R-Mutura/eco_boda_display/images/1 Eco_display.png

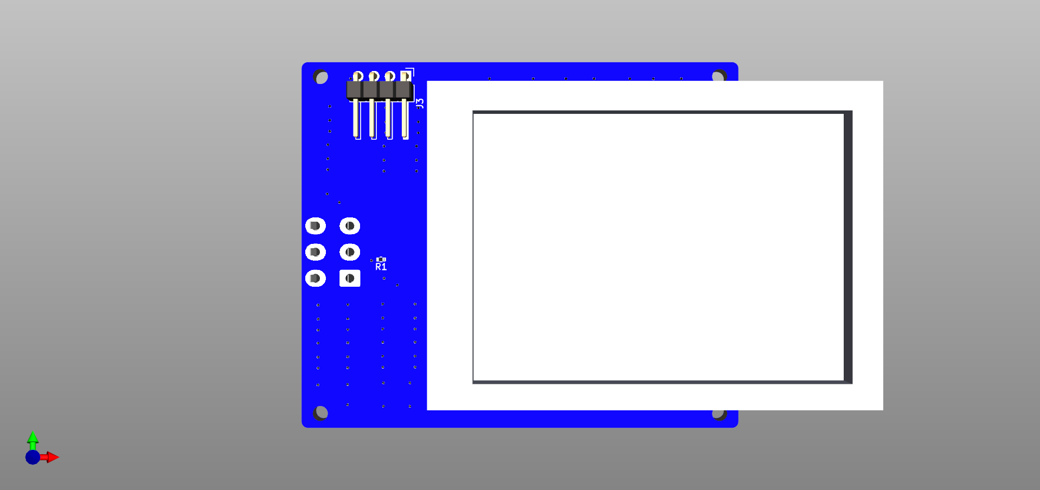
images/1 Eco_display.png
