R-Mutura/eco_boda_display/images/2 Eco_display.png

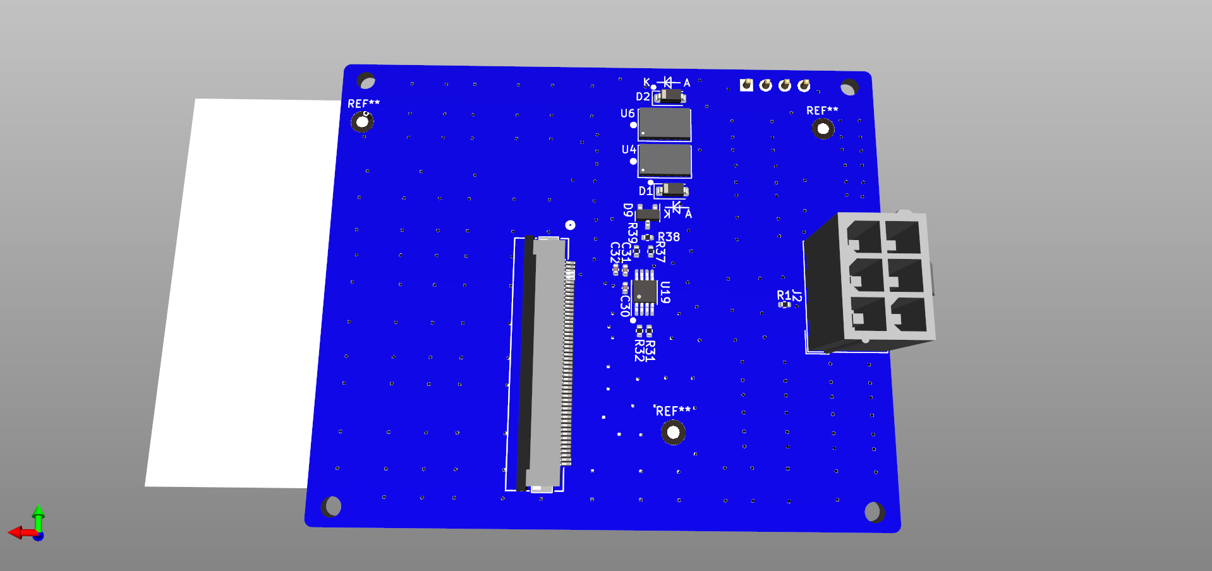
images/2 Eco_display.png
