R-Mutura/eco_boda_display/images/Eco_display.png

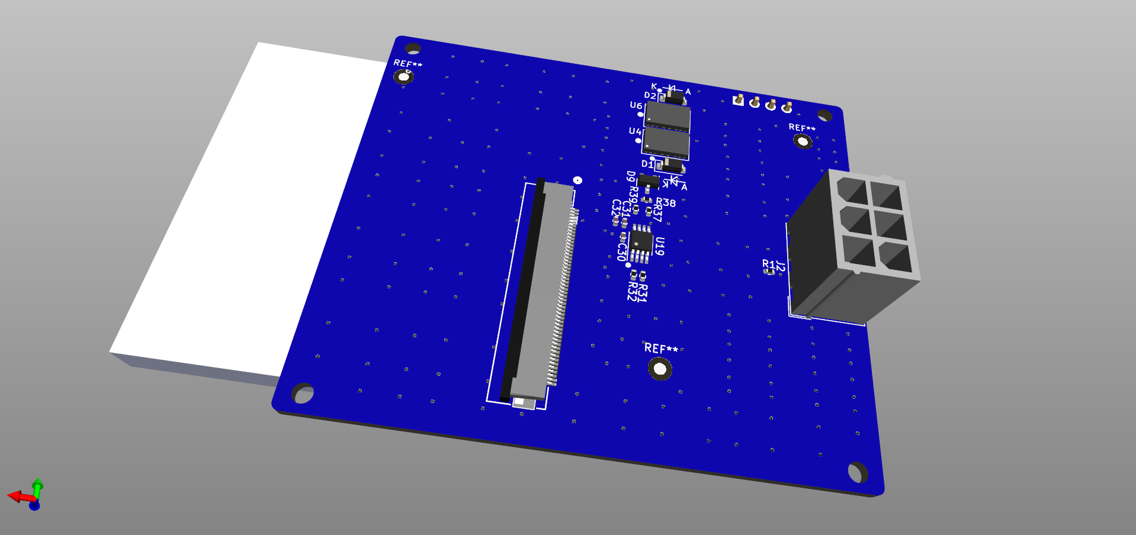
images/Eco_display.png
