R-Mutura/eco_boda_display/STEP/Eco_display.step

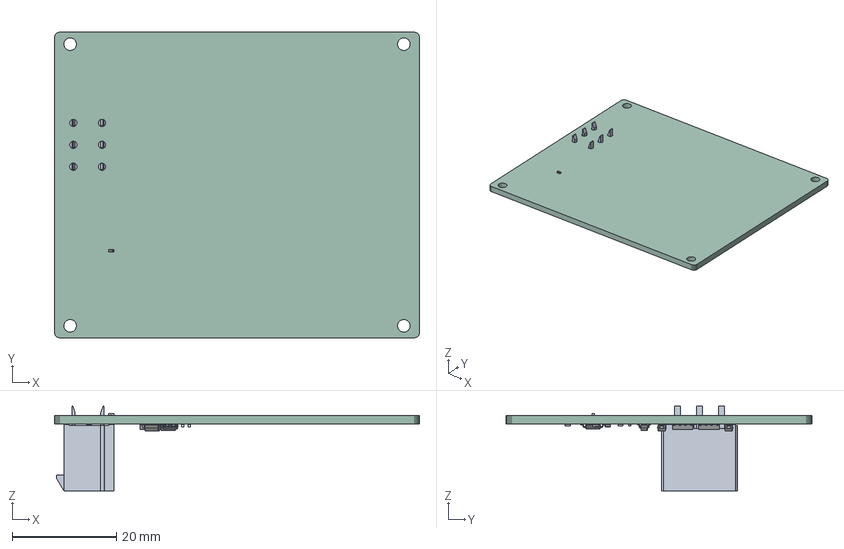
[picture p4: CAD file, 2024-01-16]
STEP/Eco_display.step
70.0 x 58.6 x 16.3 mm
R_0402_1005Metric x 6
TBU-CA065-300-WH x 2
SOT_23
C_0402_1005Metric x 3
MSOP_8_3x3mm_P065mm
D_SOD_123 x 2
Eco_display PCB
