R-Mutura/eco_boda_display/sch_pdf/Eco_display.pdf

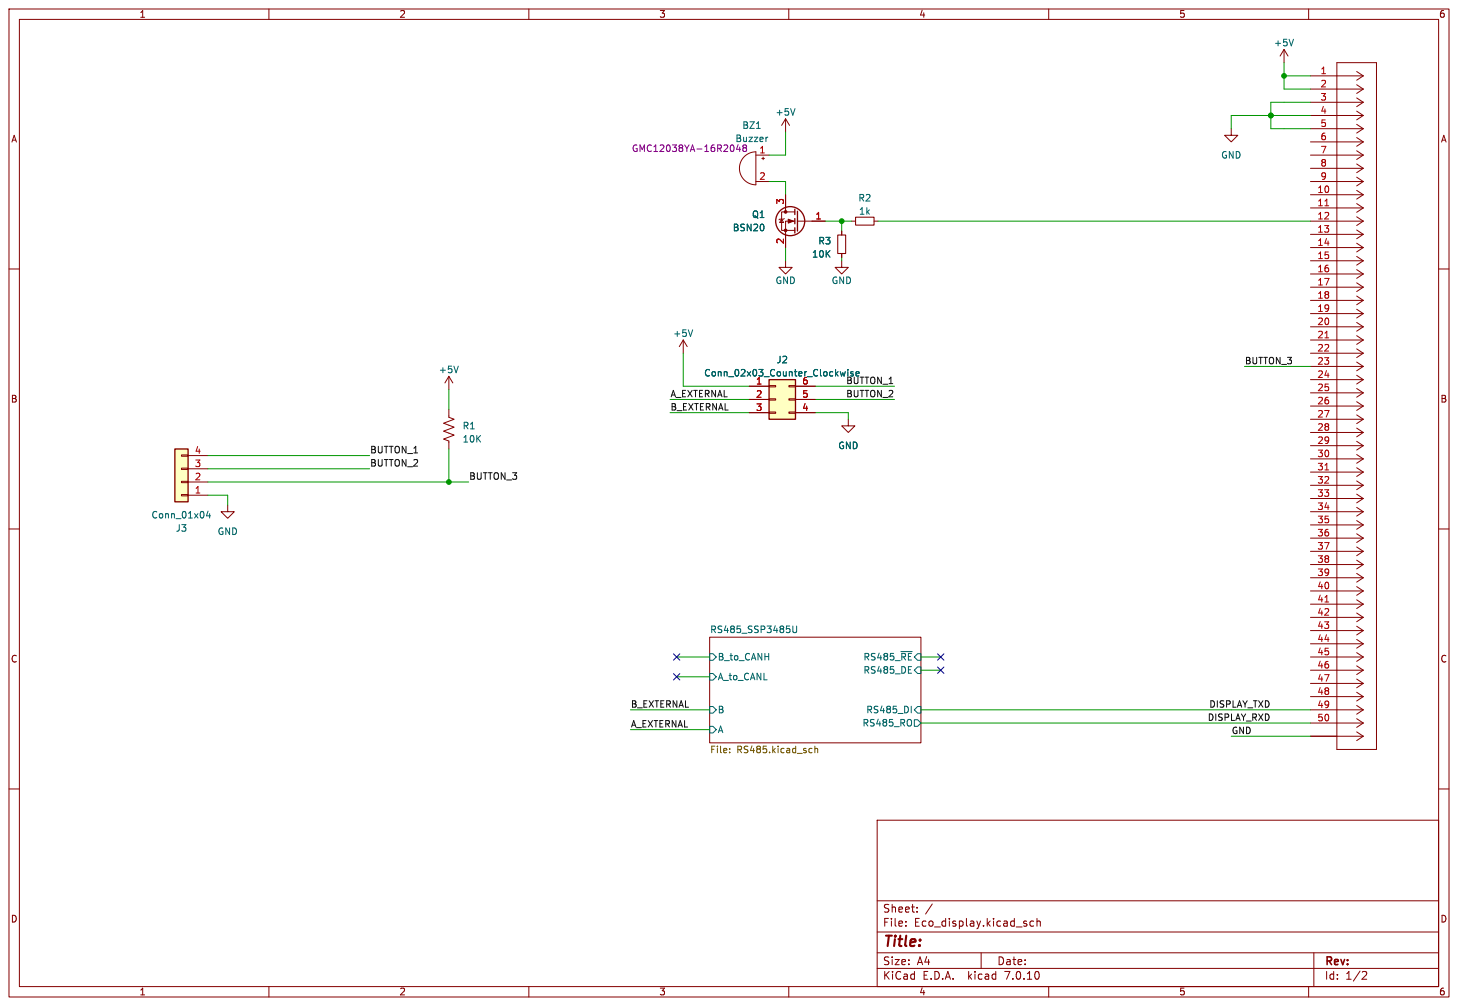
[picture p5: page 1]

Id: 1/2 Title: File: Eco_display.kicad_sch Sheet: / B_to_CANH

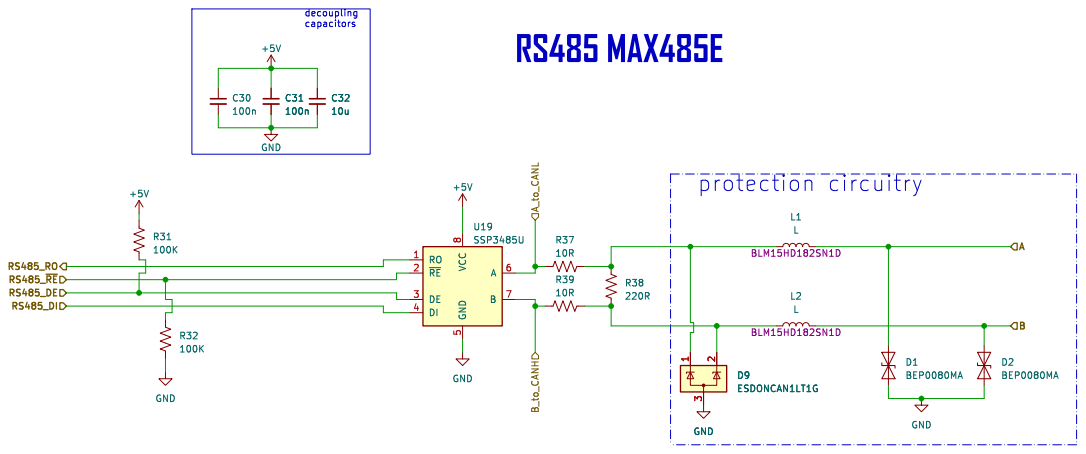
[picture p6: page 2]

decoupling capacitors

10u GND

Id: 2/2 Title: File: RS485.kicad_sch Sheet: /RS485_SSP3485U/ GND
