R-Mutura/eco_boda_display/sch_pdf/BOTTON_PLACEMENT_FILE_ECO_DISPLAY.pdf

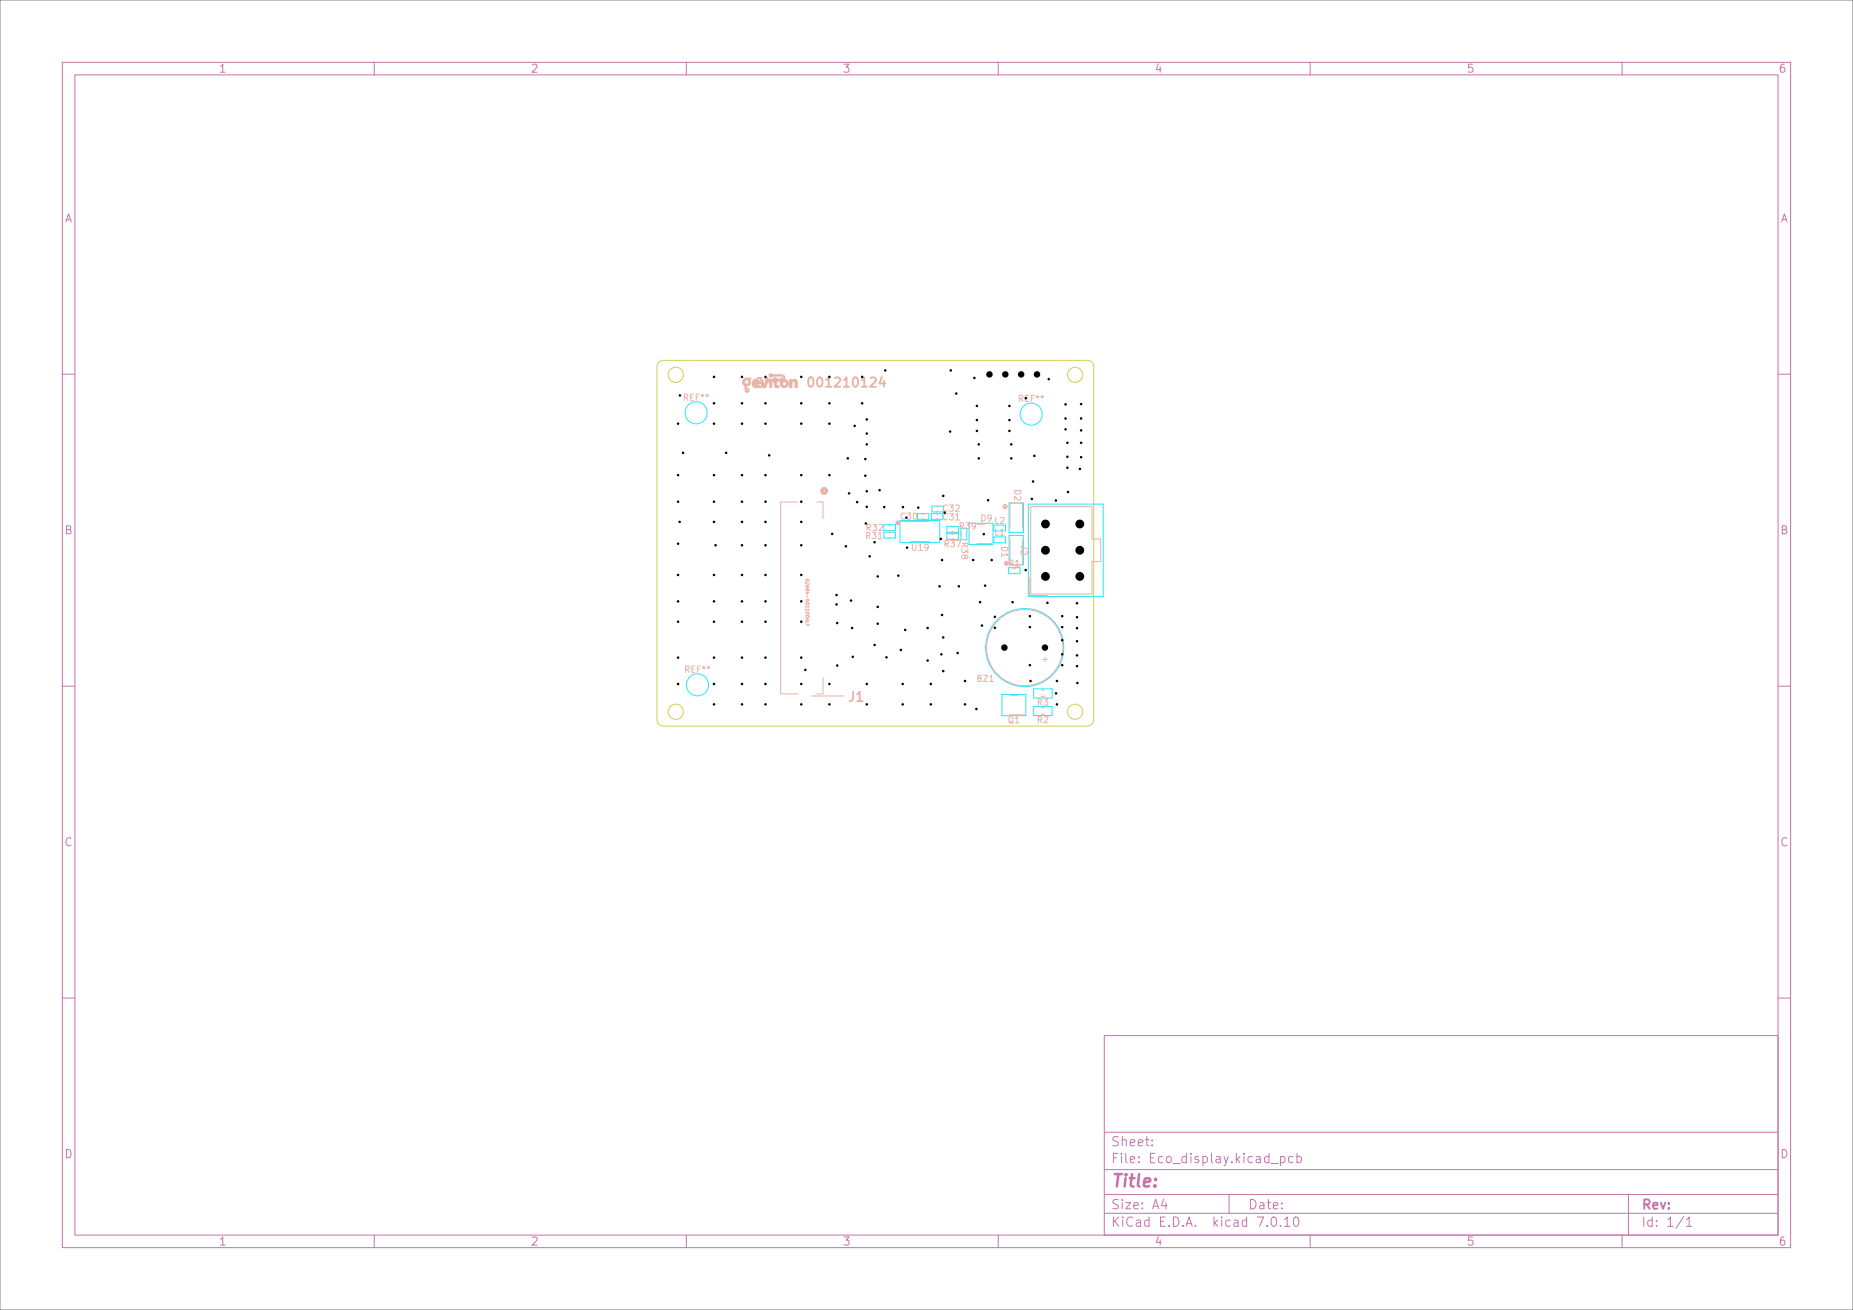
[picture p7: page 1]
