R-Mutura/eco_boda_display/sch_pdf/TOP_PLACEMENT_FILE_ECO_DISPLAY.pdf

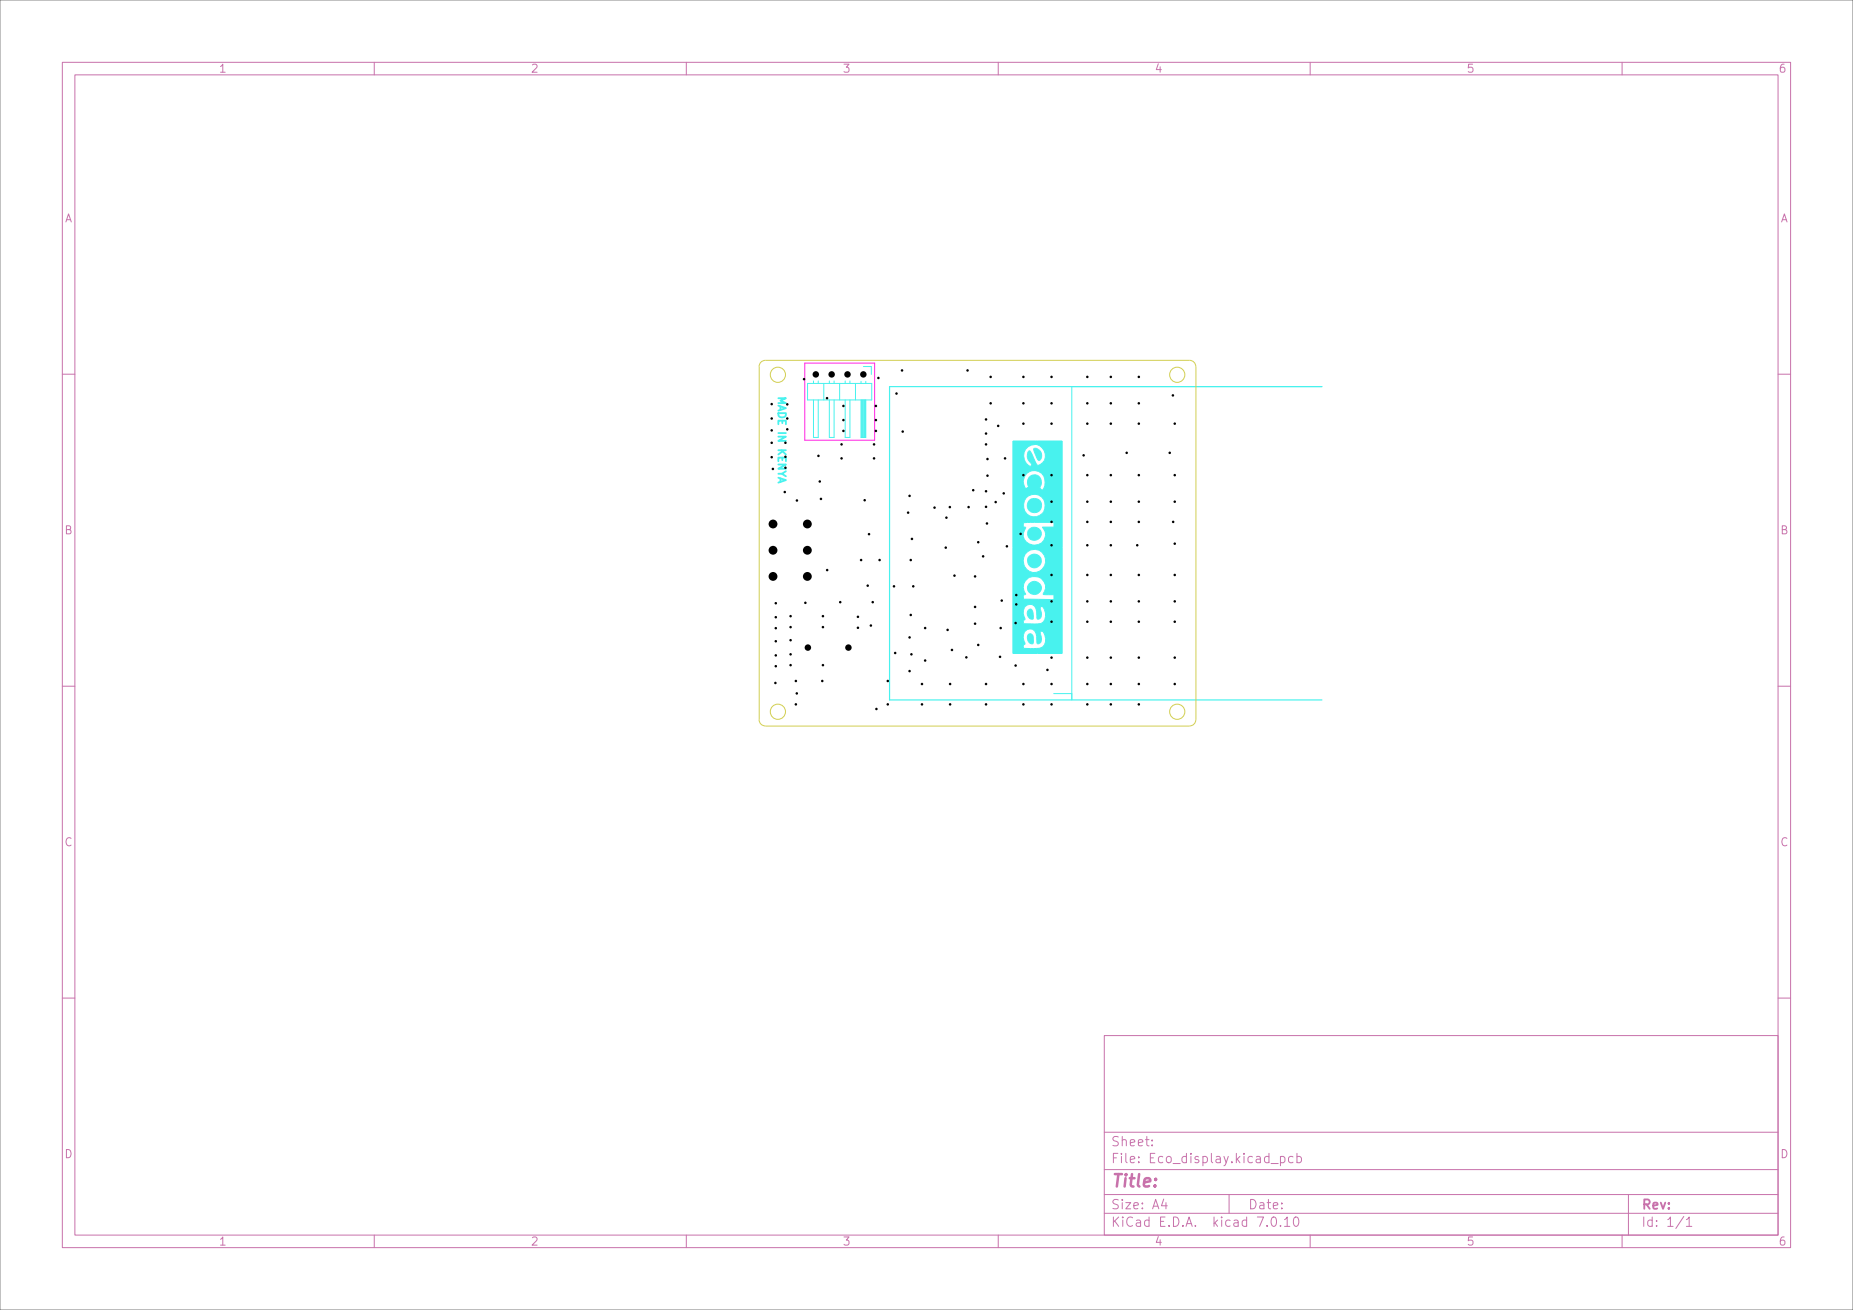
[picture p8: page 1]
