R-Mutura/eco_boda_display/sch_pdf/Eco_display-RS485_SSP3485U.pdf

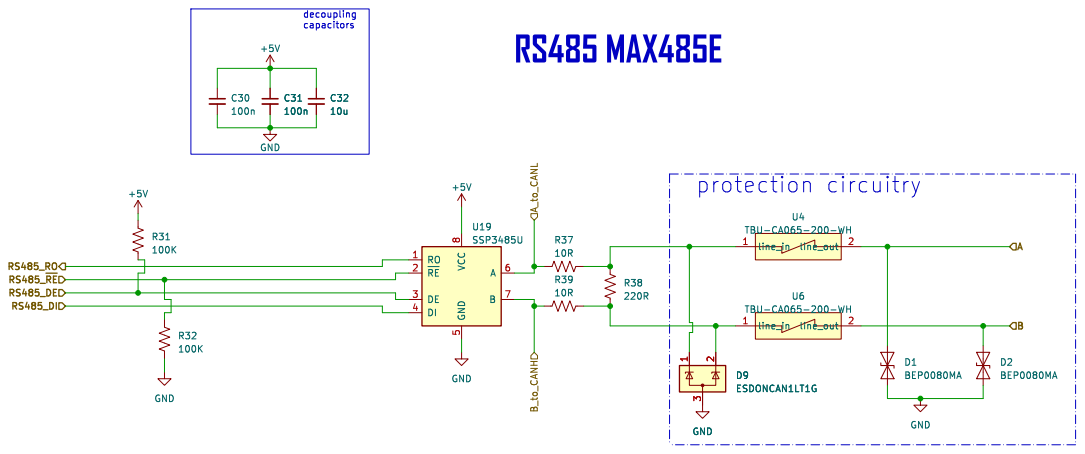
[picture p9: page 1]
