R-Mutura/eco_boda_display/(commit log)

2024-01-16 updates on BOM and production files
    [Eco_display-B_Cu.gbr, Eco_display-B_Mask.gbr, Eco_display-B_Paste.gbr, Eco_display-B_Silkscreen.gbr, Eco_display-Edge_Cuts.gbr, Eco_display-F_Cu.gbr, Eco_display-F_Mask.gbr, Eco_display-F_Paste.gbr]
2024-01-20 connector placement update and all prouction files
    [Eco_display-B_Cu.gbr, Eco_display-B_Mask.gbr, Eco_display-B_Paste.gbr, Eco_display-B_Silkscreen.gbr, Eco_display-Edge_Cuts.gbr, Eco_display-F_Cu.gbr, Eco_display-F_Mask.gbr, Eco_display-F_Paste.gbr]
2024-01-20 completed updates and BOM
    [Eco_display.xlsx]
2024-01-20 sep files updates
    [Eco_display-B_Cu.gbr, Eco_display-B_Mask.gbr, Eco_display-B_Paste.gbr, Eco_display-B_Silkscreen.gbr, Eco_display-Edge_Cuts.gbr, Eco_display-F_Cu.gbr, Eco_display-F_Mask.gbr, Eco_display-F_Paste.gbr]
2024-01-20 routing section matching completed
    [Eco_display.kicad_pcb]
2024-01-20 update to remove errors and update all production files
    [Eco_display-B_Cu.gbr, Eco_display-B_Mask.gbr, Eco_display-B_Paste.gbr, Eco_display-B_Silkscreen.gbr, Eco_display-Edge_Cuts.gbr, Eco_display-F_Cu.gbr, Eco_display-F_Mask.gbr, Eco_display-F_Paste.gbr]
2024-01-20 updates on resistor fiducial and all production files
    [Eco_display-B_Cu.gbr, Eco_display-B_Mask.gbr, Eco_display-B_Paste.gbr, Eco_display-B_Silkscreen.gbr, Eco_display-Edge_Cuts.gbr, Eco_display-F_Cu.gbr, Eco_display-F_Mask.gbr, Eco_display-F_Paste.gbr]
2024-01-20 DIODE MARKING UPDATES
    [Eco_display-B_Cu.gbr, Eco_display-B_Mask.gbr, Eco_display-B_Paste.gbr, Eco_display-B_Silkscreen.gbr, Eco_display-Edge_Cuts.gbr, Eco_display-F_Cu.gbr, Eco_display-F_Mask.gbr, Eco_display-F_Paste.gbr]
2024-01-21 diode label update
    [Eco_display-B_Cu.gbr, Eco_display-B_Mask.gbr, Eco_display-B_Paste.gbr, Eco_display-B_Silkscreen.gbr, Eco_display-Edge_Cuts.gbr, Eco_display-F_Cu.gbr, Eco_display-F_Mask.gbr, Eco_display-F_Paste.gbr]
2024-01-21 ALL ITEMS UPDATED
    [Eco_display-B_Cu.gbr, Eco_display-B_Mask.gbr, Eco_display-B_Paste.gbr, Eco_display-B_Silkscreen.gbr, Eco_display-Edge_Cuts.gbr, Eco_display-F_Cu.gbr, Eco_display-F_Mask.gbr, Eco_display-F_Paste.gbr]
2024-01-22 display connector push by 3.5mm update and all the files
    [Eco_display-B_Cu.gbr, Eco_display-B_Mask.gbr, Eco_display-B_Paste.gbr, Eco_display-B_Silkscreen.gbr, Eco_display-Edge_Cuts.gbr, Eco_display-F_Cu.gbr, Eco_display-F_Mask.gbr, Eco_display-F_Paste.gbr]
2024-01-26 completed addition of buzzer
    [Eco_display-B_Cu.gbr, Eco_display-B_Mask.gbr, Eco_display-B_Paste.gbr, Eco_display-B_Silkscreen.gbr, Eco_display-Edge_Cuts.gbr, Eco_display-F_Cu.gbr, Eco_display-F_Mask.gbr, Eco_display-F_Paste.gbr]
2024-01-27 Logo, routing, all files
    [Eco_display-B_Cu.gbr, Eco_display-B_Mask.gbr, Eco_display-B_Paste.gbr, Eco_display-B_Silkscreen.gbr, Eco_display-Edge_Cuts.gbr, Eco_display-F_Cu.gbr, Eco_display-F_Mask.gbr, Eco_display-F_Paste.gbr]
2024-01-28 gerber and placement files updates
    [Eco_display-B_Cu.gbr, Eco_display-B_Mask.gbr, Eco_display-B_Paste.gbr, Eco_display-B_Silkscreen.gbr, Eco_display-Edge_Cuts.gbr, Eco_display-F_Cu.gbr, Eco_display-F_Mask.gbr, Eco_display-F_Paste.gbr]
2024-01-28 all prduction files updated - removed designators
    [Eco_display-B_Cu.gbr, Eco_display-B_Mask.gbr, Eco_display-B_Paste.gbr, Eco_display-B_Silkscreen.gbr, Eco_display-Edge_Cuts.gbr, Eco_display-F_Cu.gbr, Eco_display-F_Mask.gbr, Eco_display-F_Paste.gbr]
2024-02-07 coplete addition of BOM and placement guide pdf files
    [Eco_display.csv, Eco_display.kicad_pcb, Eco_display.xlsx]
